Haden-Min/CNN_YOLO_AI_accelerator/legacy/for_conference/dataflow.pptx

## CNN HW Dataflow

2024.07.25 (목)
민한율 한이음 발표자료

## Index

- CONV Layer
- BatchNormalization
- Conv2D
- Input Data
- Data Type
- Quantization
- INT8 Data Flow

## About CONV Layer

Structures of Convolutional Layer

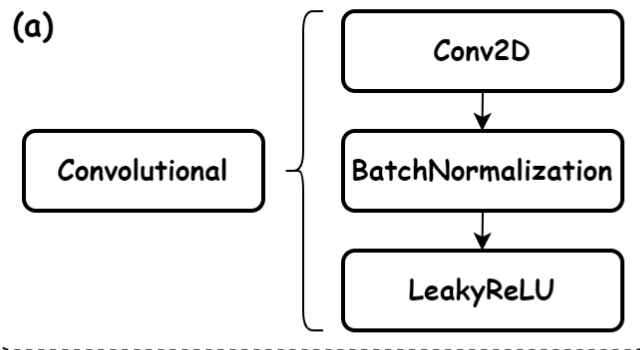
[picture p1: figure]

## (1) About BatchNormalization

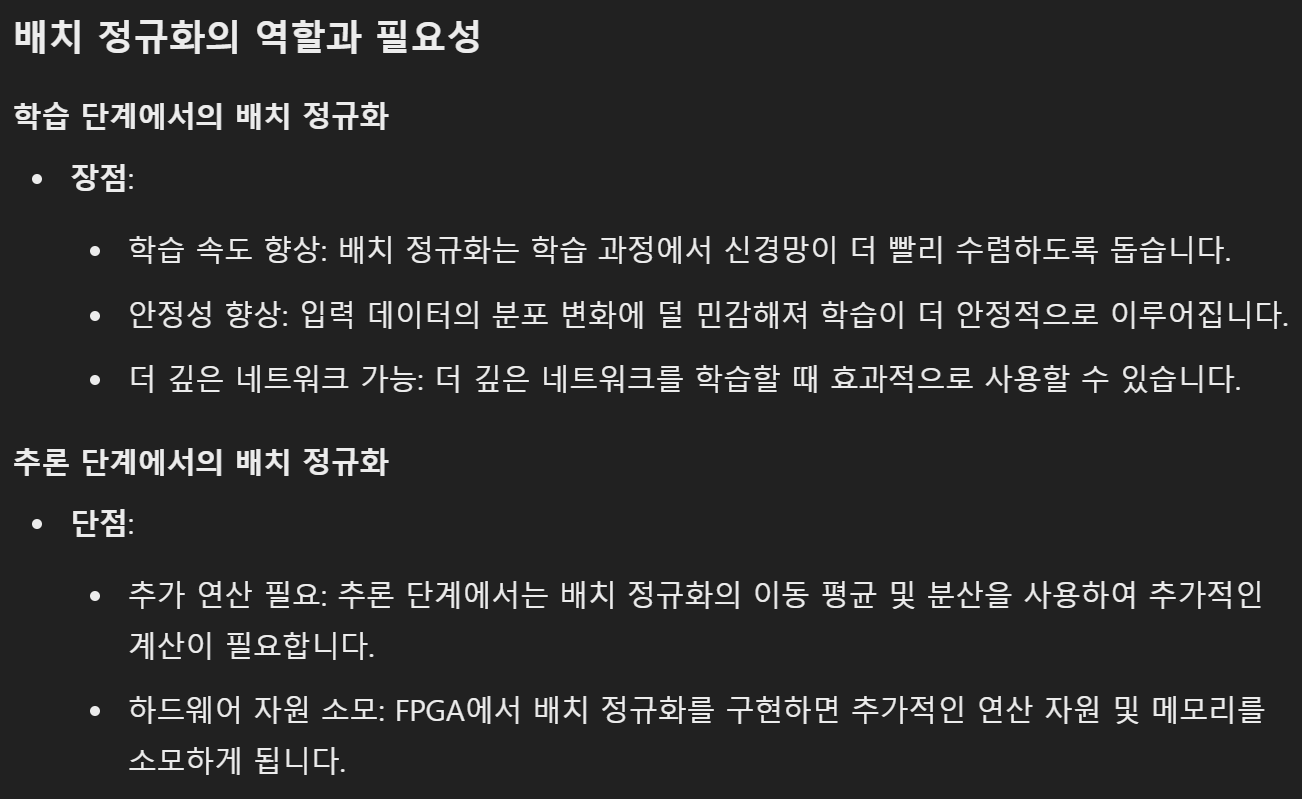
[picture p2: figure]
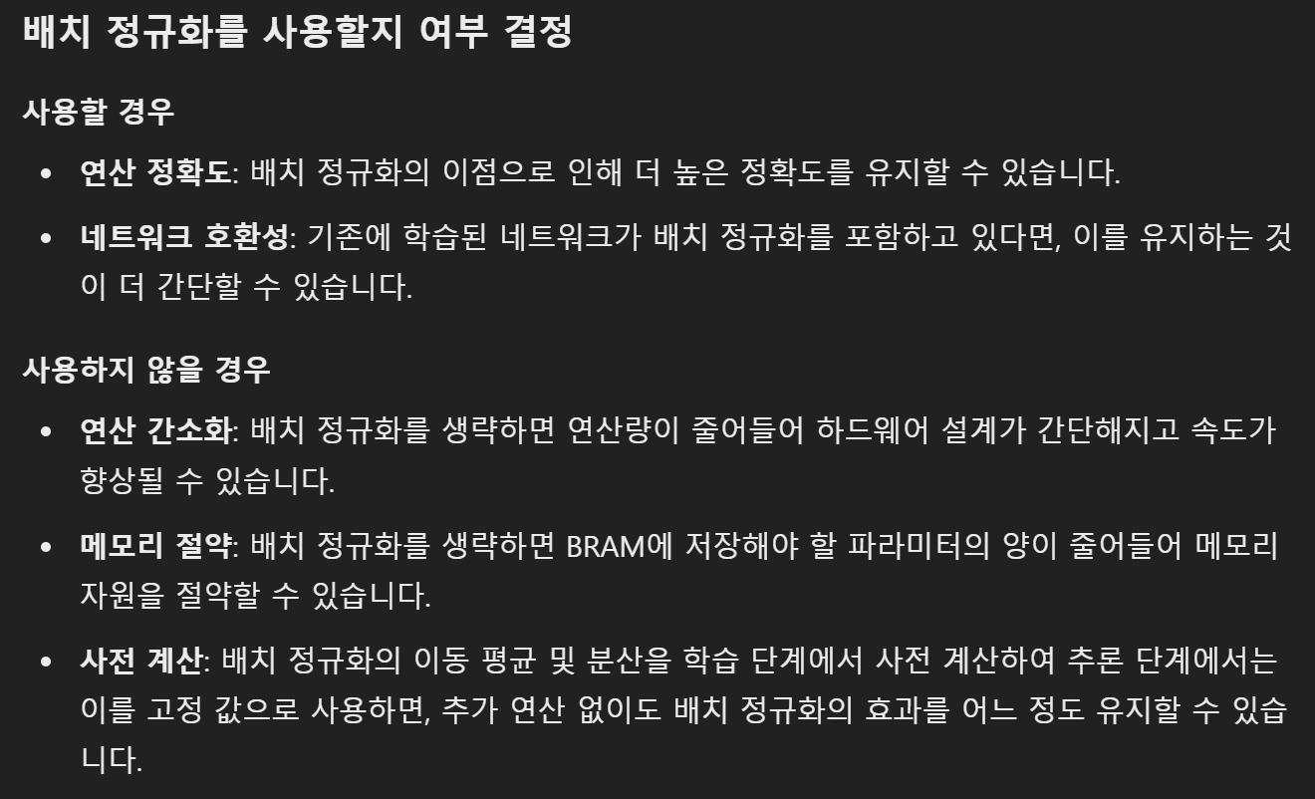
[picture p3: figure]
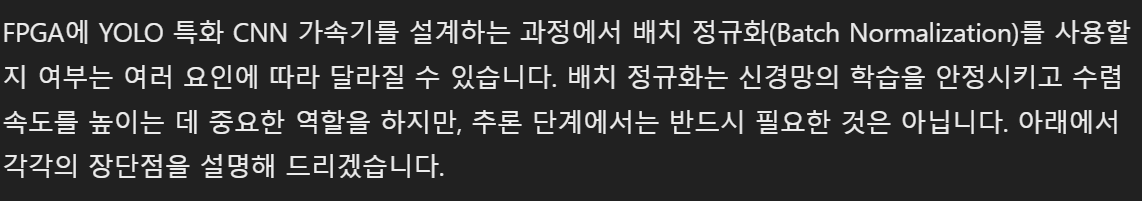
[picture p4: figure]

## (1) About BatchNormalization

Weights_Summary_Corrected.xlsx 추가 자료 참고

빨간 박스가 BatchNorm File

## (2) About Conv2D

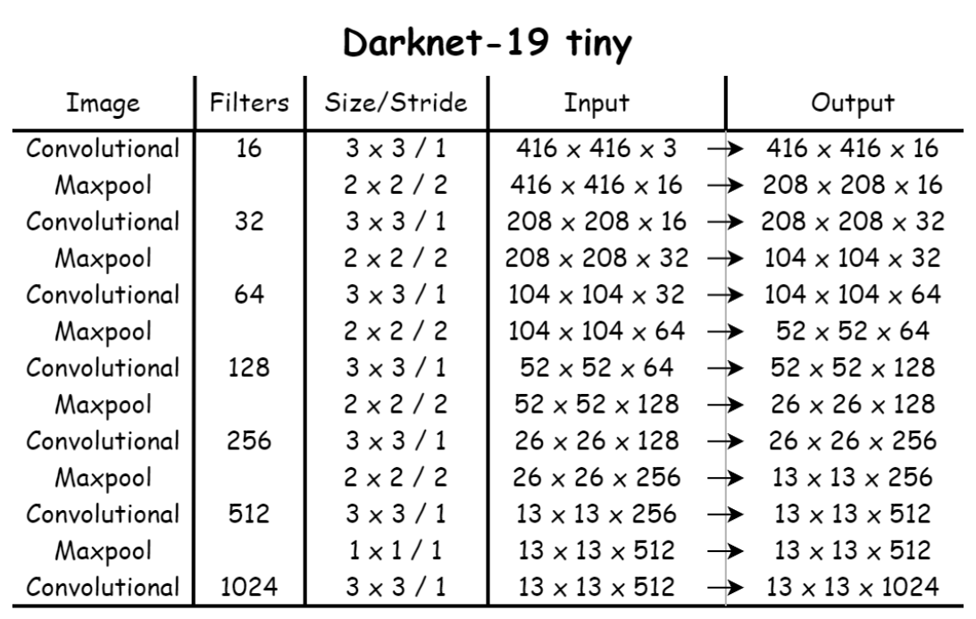
[picture p5: figure]

Example

## (2) About Conv2D

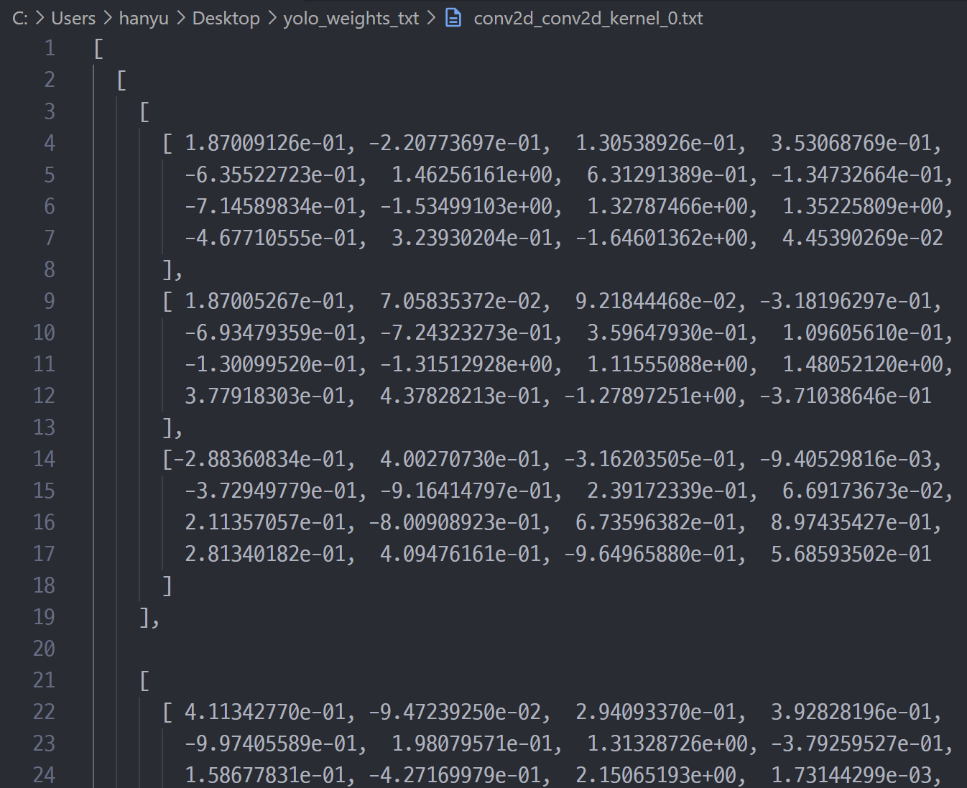
[picture p6: figure]

conv2d weight 중 일부

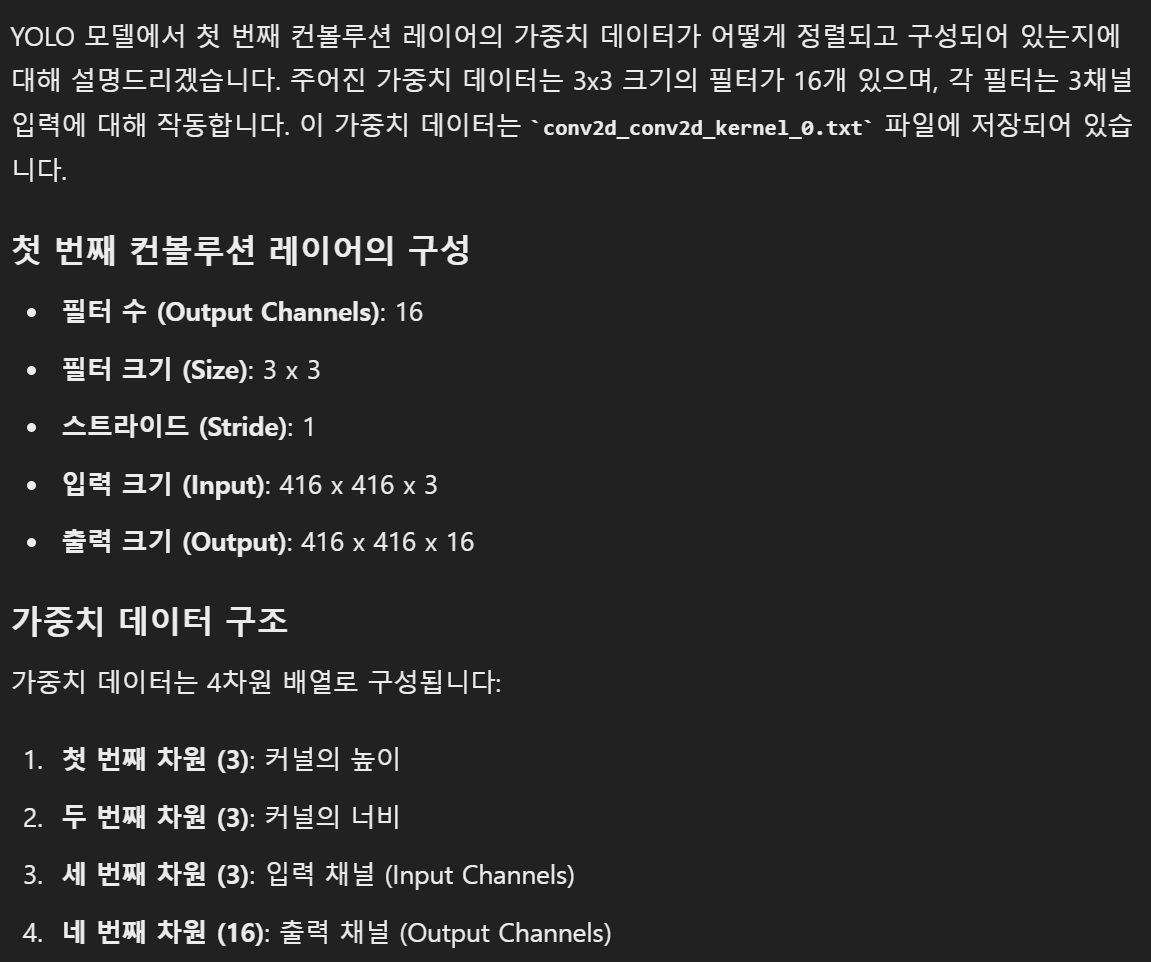
[picture p7: figure]

## (2) About Conv2D

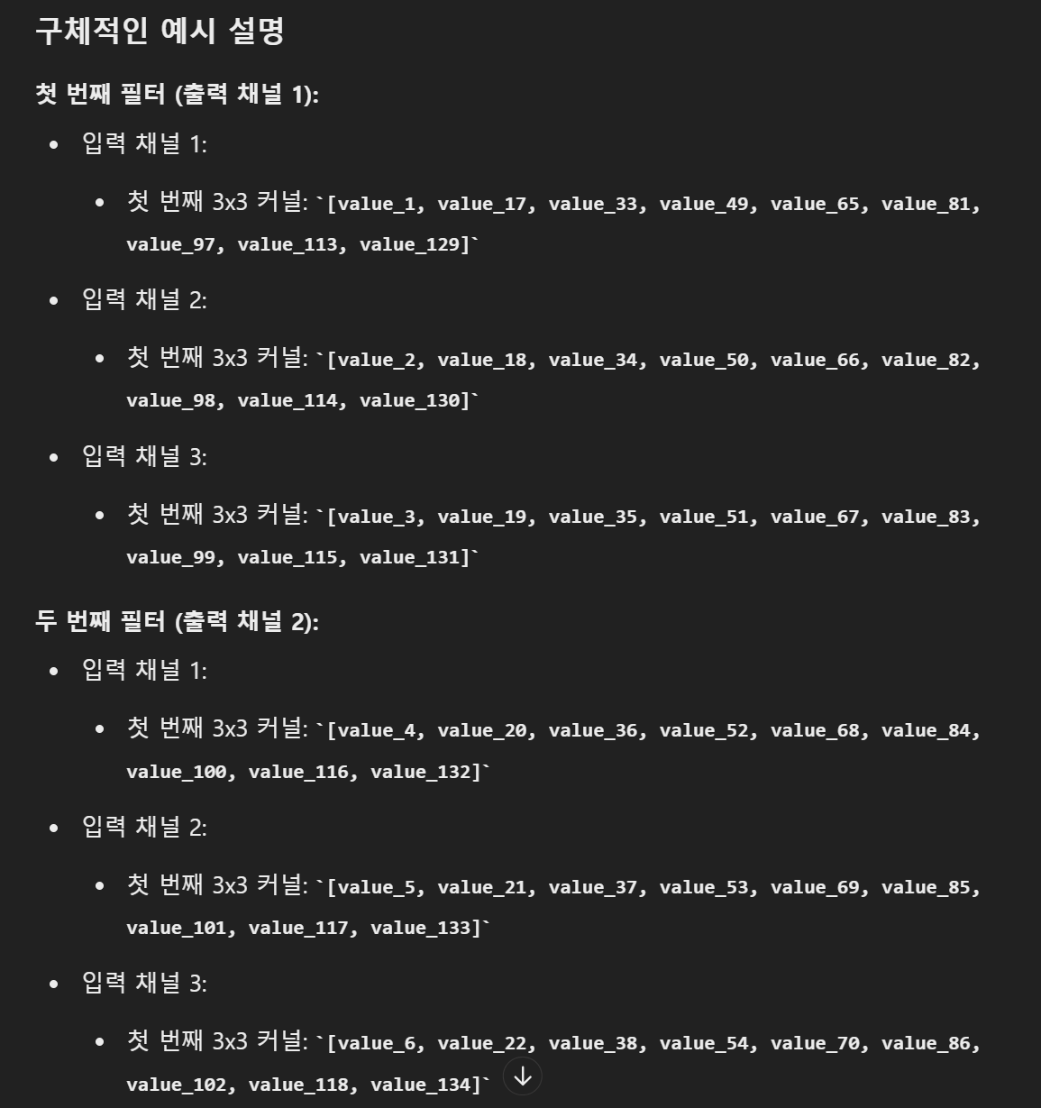
[picture p8: figure]
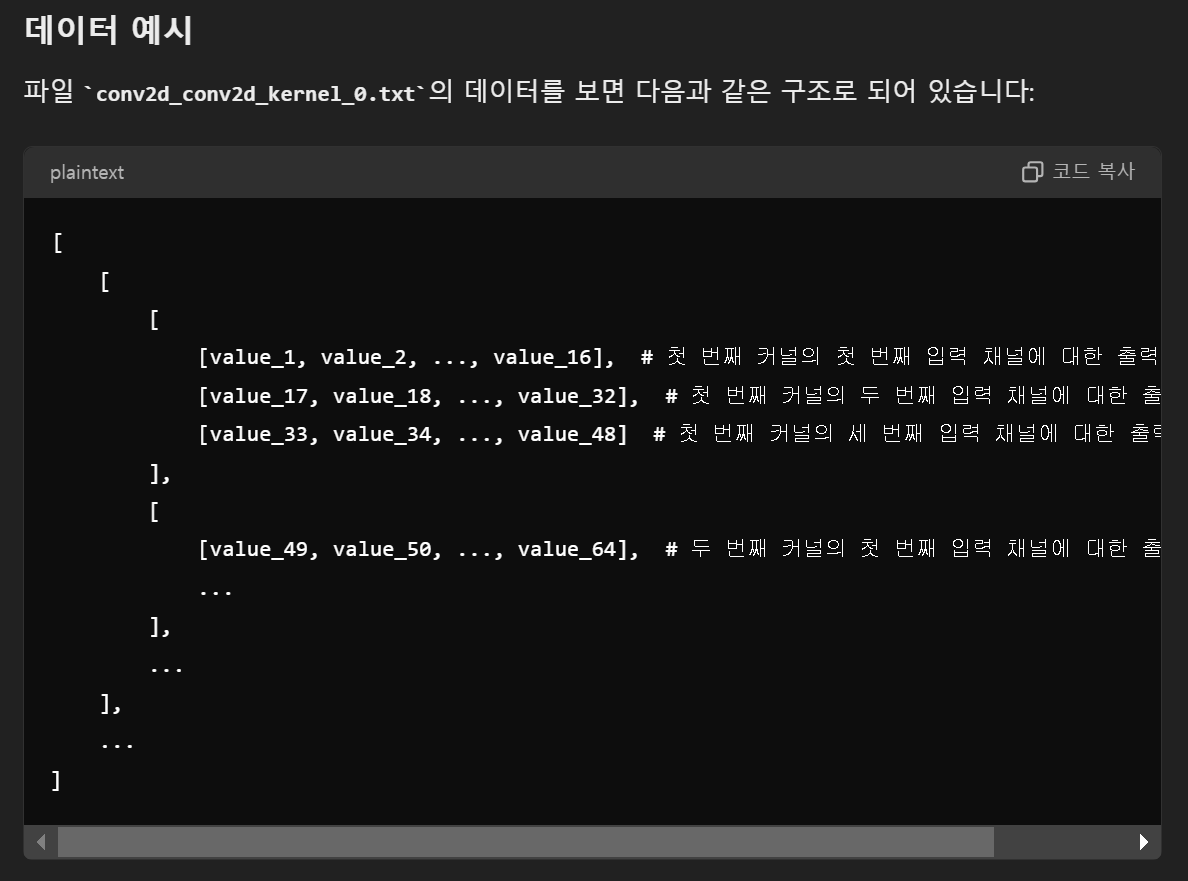
[picture p9: figure]
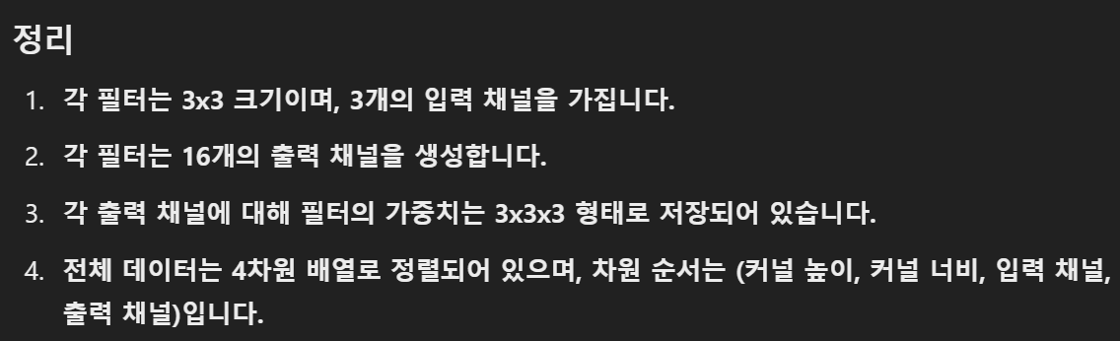
[picture p10: figure]

## (3) About Input Data

DATA

## (3) About Input Data

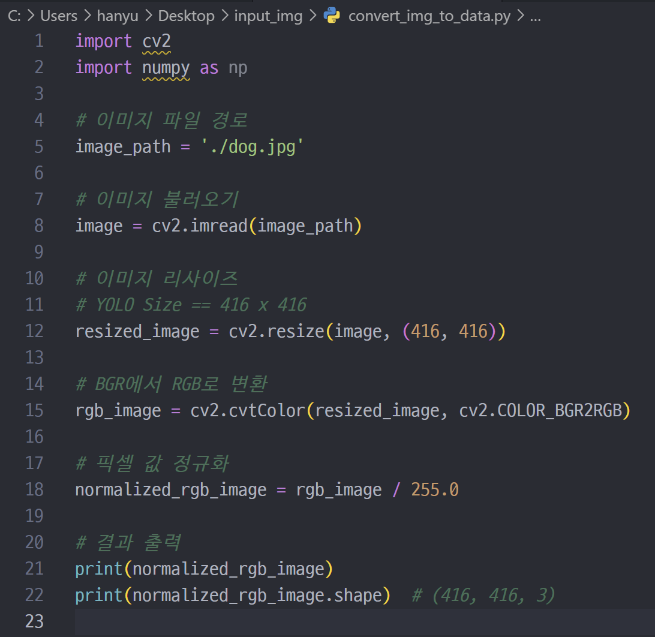
[picture p11: figure]

Reference Code in Python

참고 자료
input_img 폴더 참조

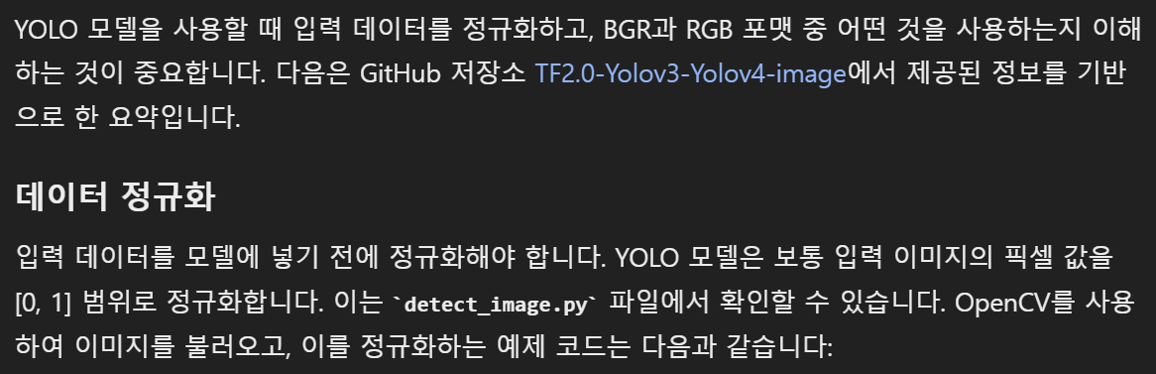
[picture p12: figure]

## (3) About Input Data

- Output

1 pixel [ R, G, B ]

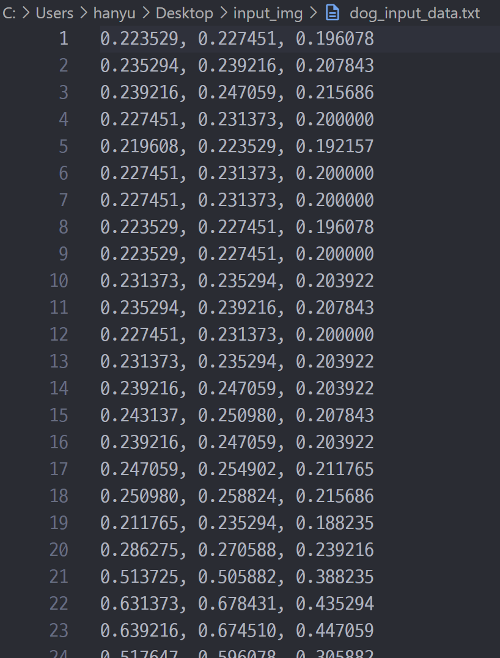
[picture p13: figure]

## (4) About Data Type

Mapping range
INT8: -128 ~ 127
FP32: 아래 사진 참고 (Q16.16 기준)

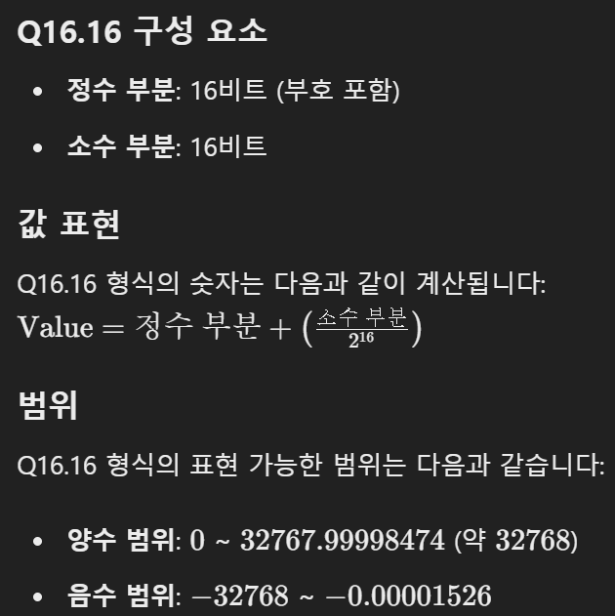
[picture p14: figure]

- INT8
- FP32 (Fixed)
- FP32 (Floating)

## (4) About Data Type

- INT8 vs FP32

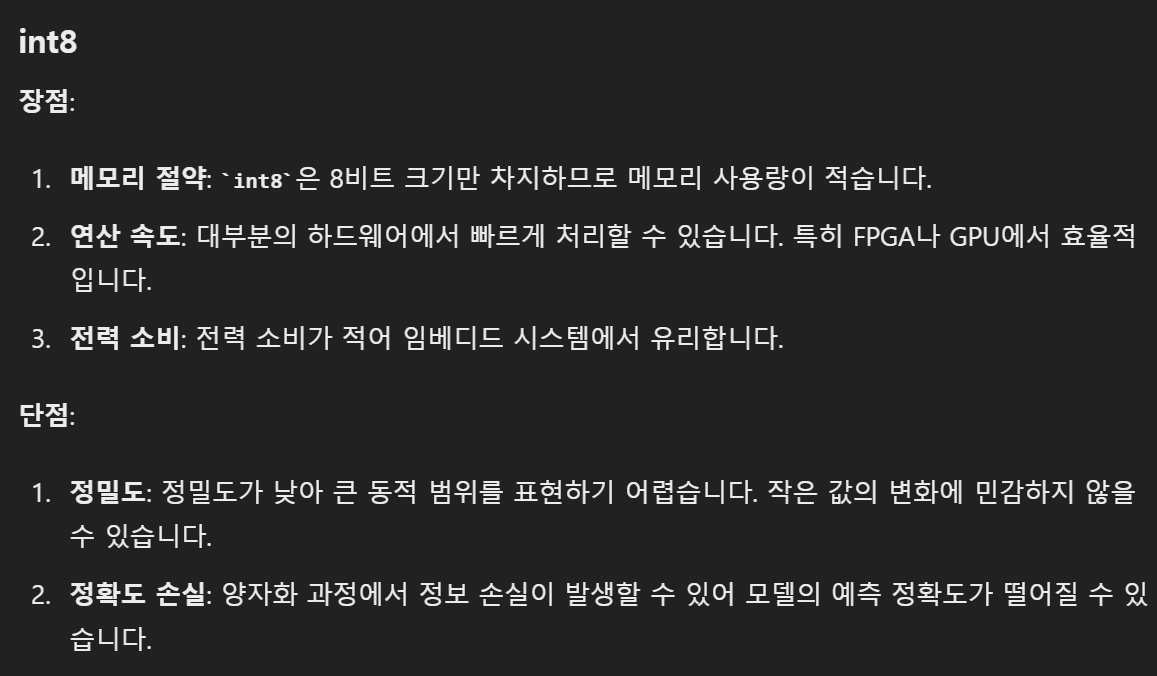
[picture p15: figure]
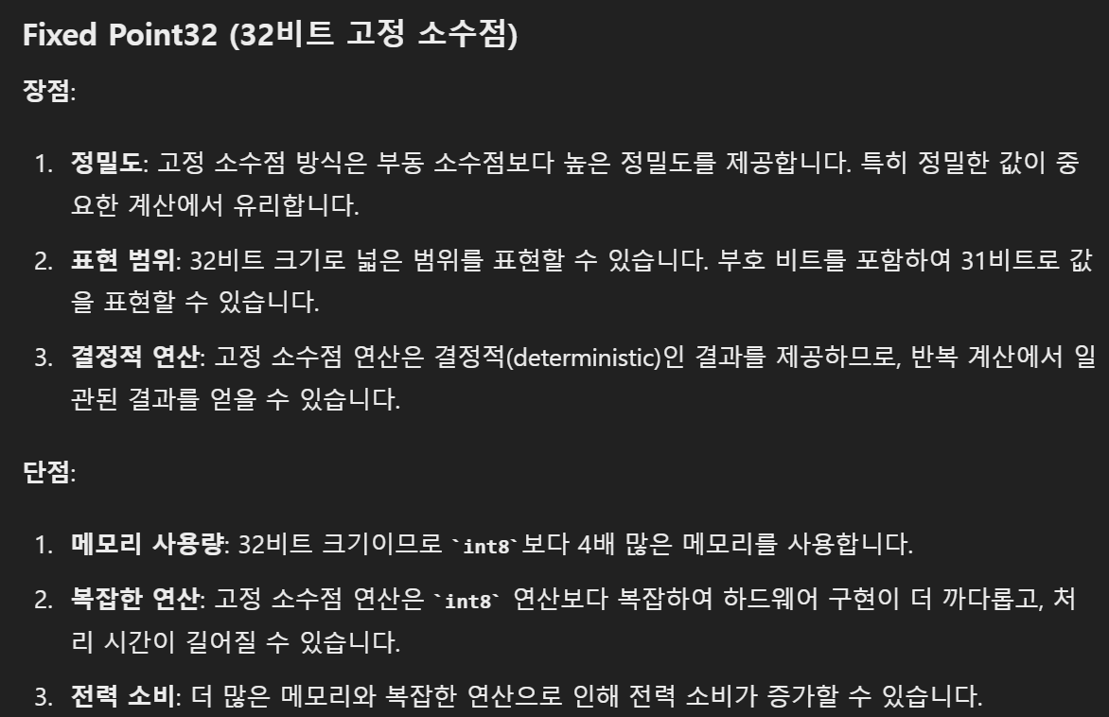
[picture p16: figure]

## (4) About Data Type

- INT8 vs FP32

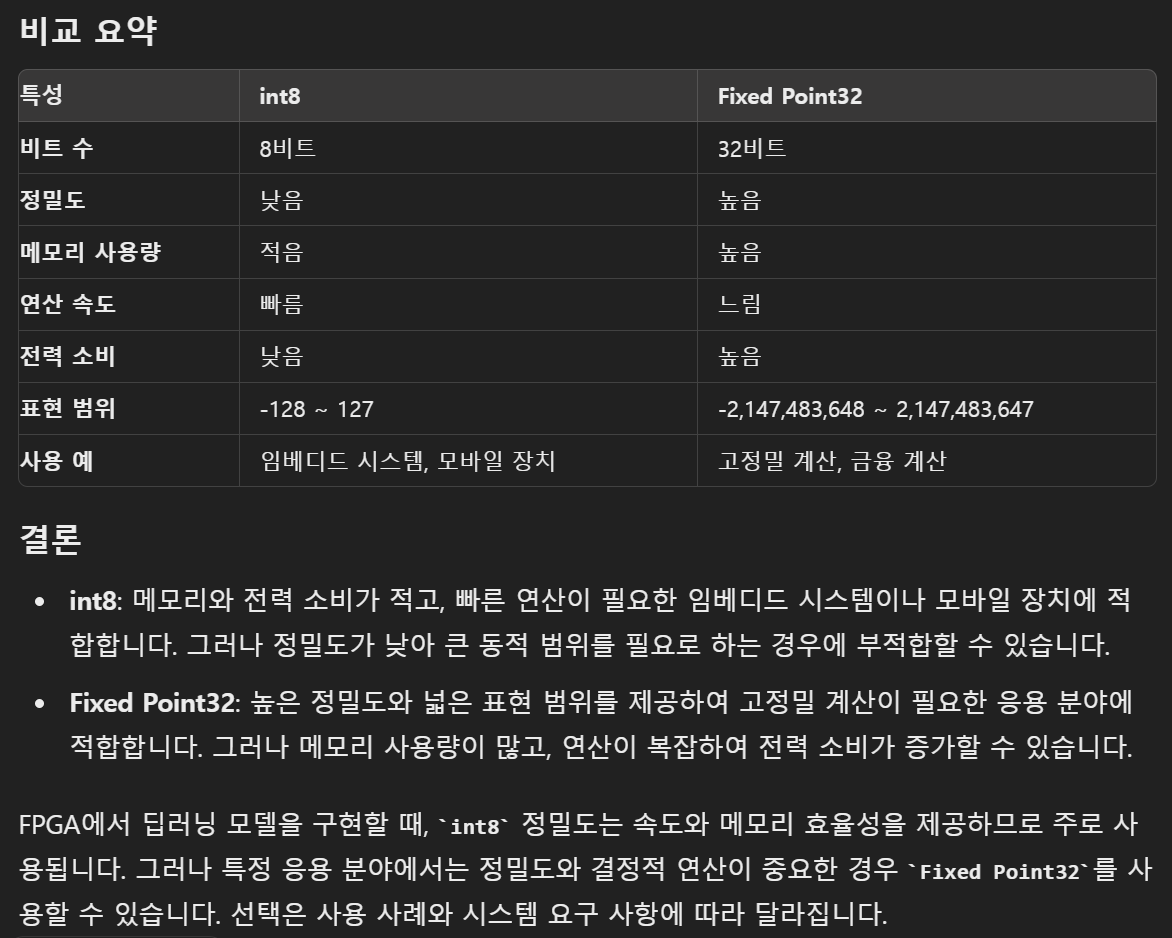
[picture p17: figure]

## (4) About Data Type

- INT8 vs FP32 (Floating Point) 곱셈기 비교

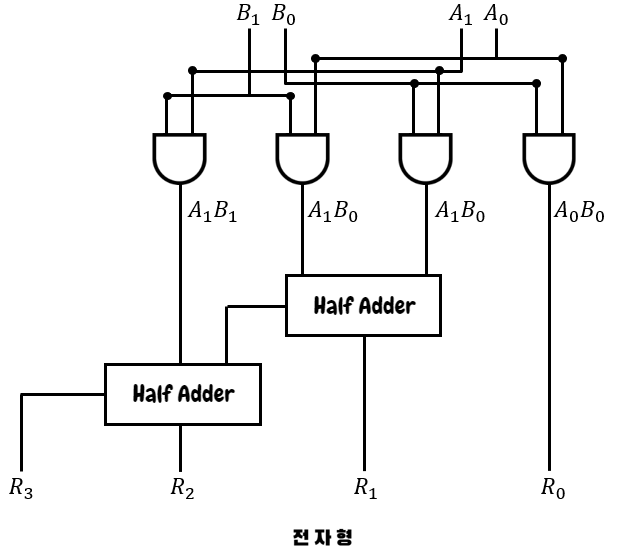
[picture p18: figure]
곱셈기 (Multiplier) - 전자형
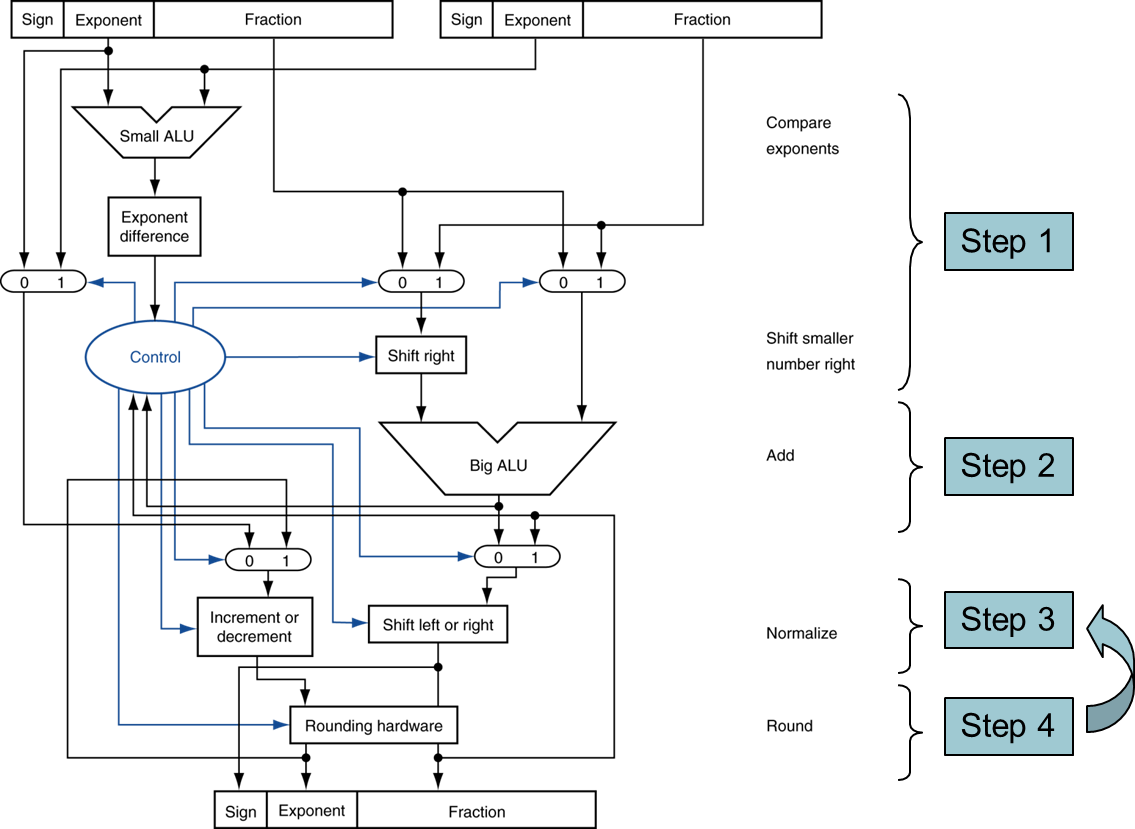
[picture p19: figure]

VS

## (5) About Quantization

- How to convert Data type??
  - “Quantization!!”

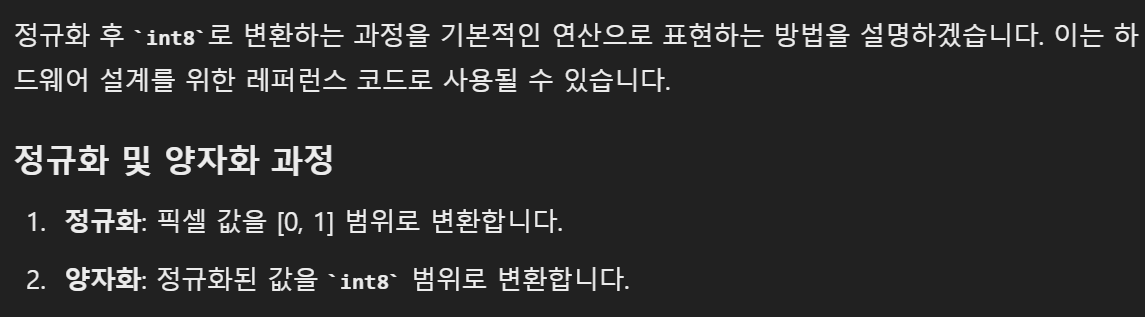
[picture p20: figure]

## (5) About Quantization

- Reference Code (input data)

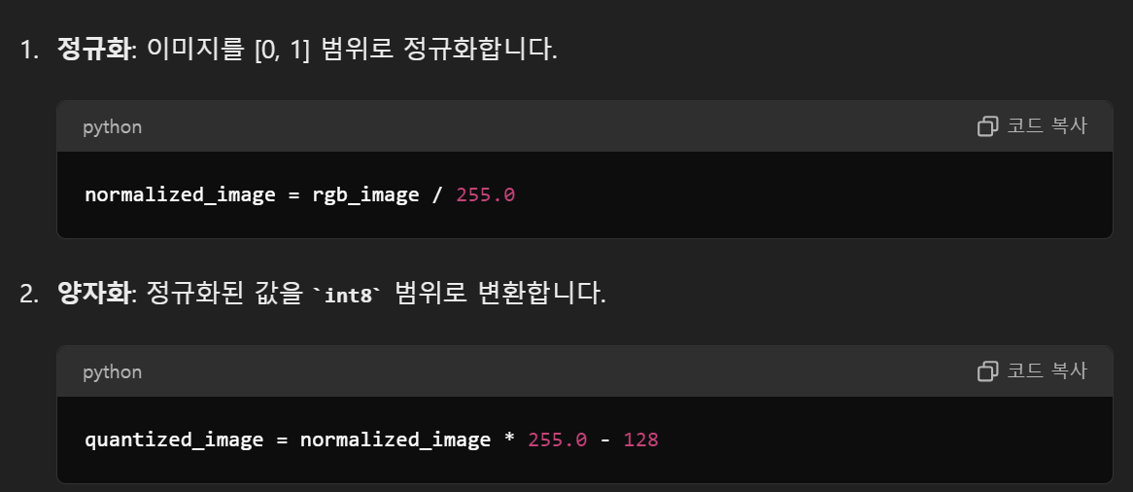
[picture p21: figure]
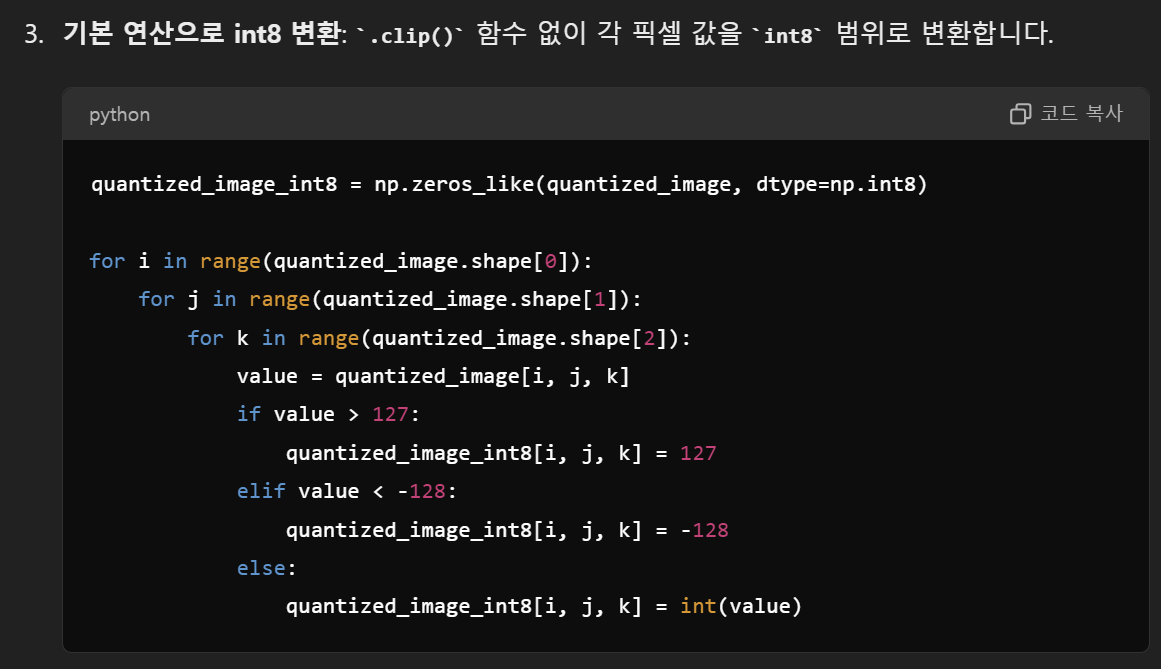
[picture p22: figure]

## (5) About Quantization

- Reference Code without normalization (input data)

## (5) About Quantization

- Why we take normalization?

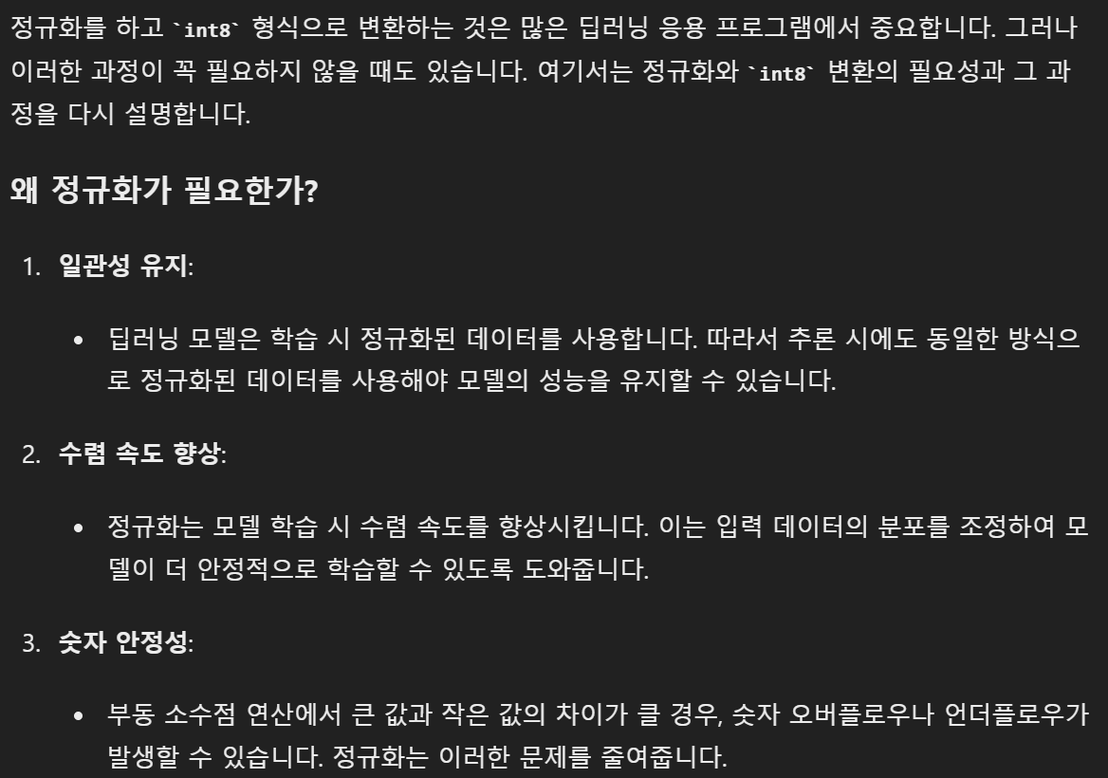
[picture p23: figure]

## (5) About Quantization

- Reference Code (weight)

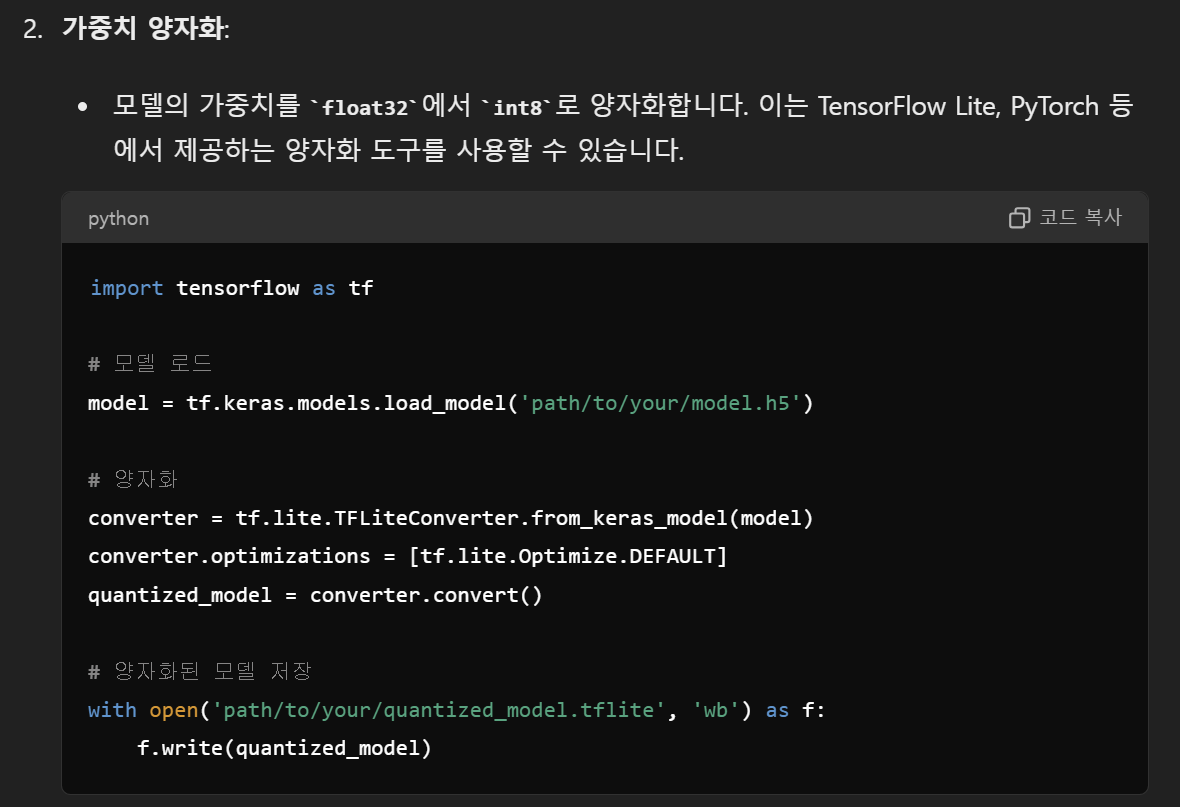
[picture p24: figure]

## (6) About INT8 Dataflow

data visualization

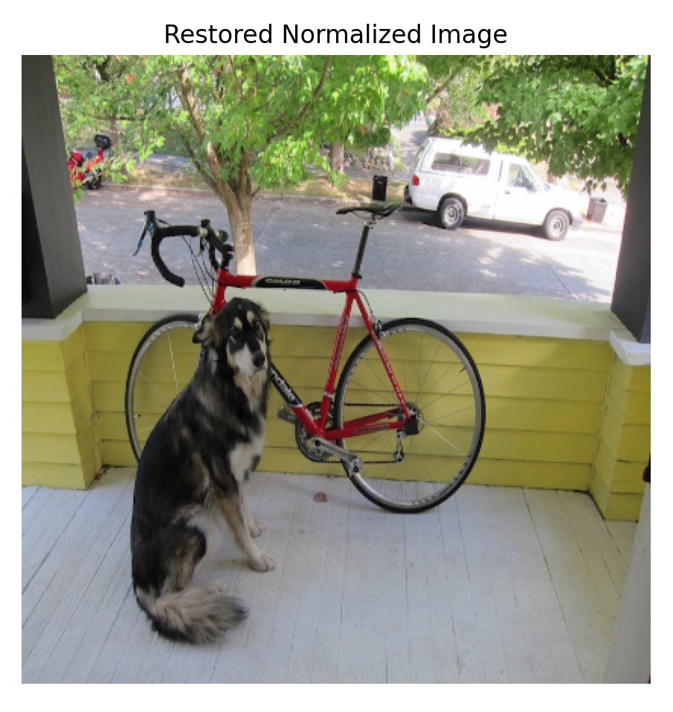
[picture p25: figure]

input image dataflow

normalization

quantization

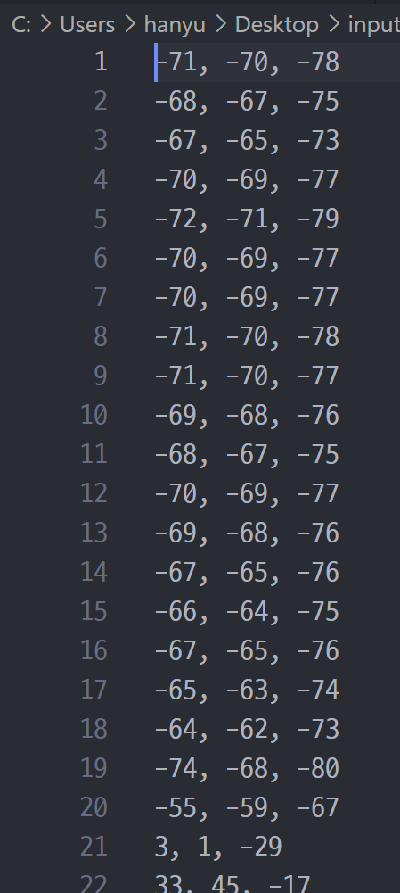
[picture p26: figure]

input img

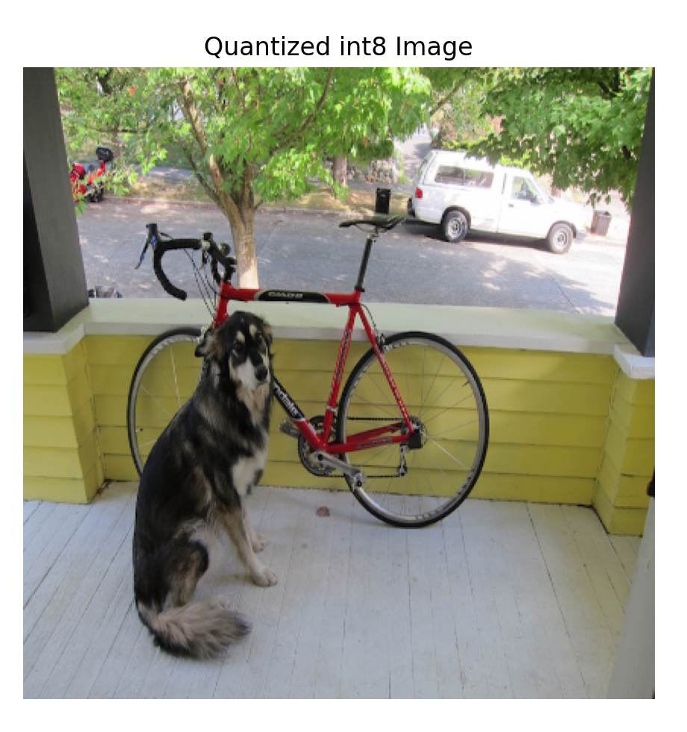
[picture p27: figure]

## (6) About INT8 Dataflow

data visualization

our goal

normalization

quantization

input img

FPGA YOLO Operation

## (6) About INT8 Dataflow

- Weight

구현 실패…
