Haden-Min/CNN_YOLO_AI_accelerator/rtl/tb/tb_single_conv_pipeline.v

`timescale 1ns/1ps

module tb_single_conv_pipeline;
    localparam DATA_WIDTH = 8;
    localparam MUL_WIDTH  = 16;
    localparam ACC_WIDTH  = 32;
    localparam IC = 1;
    localparam OC = 1;
    localparam IN_H = 5;
    localparam IN_W = 5;
    localparam K_H = 3;
    localparam K_W = 3;
    localparam OUT_H = 3;
    localparam OUT_W = 3;
    localparam INPUT_SIZE = IC * IN_H * IN_W;
    localparam WEIGHT_SIZE = OC * IC * K_H * K_W;
    localparam BIAS_SIZE = OC;
    localparam OUTPUT_SIZE = OC * OUT_H * OUT_W;
    localparam INPUT_ADDR_WIDTH = 5;
    localparam WEIGHT_ADDR_WIDTH = 4;
    localparam BIAS_ADDR_WIDTH = 1;
    localparam OUTPUT_ADDR_WIDTH = 4;

    reg clk;
    reg rst_n;
    reg start_i;

    reg input_load_en_i;
    reg [INPUT_ADDR_WIDTH-1:0] input_load_addr_i;
    reg signed [DATA_WIDTH-1:0] input_stream_data_i;

    reg weight_load_en_i;
    reg [WEIGHT_ADDR_WIDTH-1:0] weight_load_addr_i;
    reg signed [DATA_WIDTH-1:0] weight_stream_data_i;

    reg bias_load_en_i;
    reg [BIAS_ADDR_WIDTH-1:0] bias_load_addr_i;
    reg signed [ACC_WIDTH-1:0] bias_load_data_i;

    reg [OUTPUT_ADDR_WIDTH-1:0] output_read_addr_i;

    wire [BIAS_ADDR_WIDTH-1:0] bias_addr_o;
    wire [OUTPUT_ADDR_WIDTH-1:0] output_addr_o;
    wire output_we_o;
    wire busy_o;
    wire done_o;
    wire signed [ACC_WIDTH-1:0] output_data_o;
    wire signed [ACC_WIDTH-1:0] output_read_data_o;

    reg signed [DATA_WIDTH-1:0] input_mem [0:INPUT_SIZE-1];
    reg signed [DATA_WIDTH-1:0] weight_mem [0:WEIGHT_SIZE-1];
    reg signed [ACC_WIDTH-1:0] bias_mem [0:BIAS_SIZE-1];
    reg signed [ACC_WIDTH-1:0] expected_mem [0:OUTPUT_SIZE-1];

    integer fd;
    integer code;
    integer value;
    integer count;
    integer i;
    integer write_count;
    integer mismatch_count;
    integer readback_mismatch_count;
    integer done_seen;
    integer cycles;

    top_single_conv_pipeline #(
        .DATA_WIDTH(DATA_WIDTH),
        .MUL_WIDTH(MUL_WIDTH),
        .ACC_WIDTH(ACC_WIDTH),
        .IC(IC),
        .OC(OC),
        .IN_H(IN_H),
        .IN_W(IN_W),
        .K_H(K_H),
        .K_W(K_W),
        .OUT_H(OUT_H),
        .OUT_W(OUT_W),
        .INPUT_ADDR_WIDTH(INPUT_ADDR_WIDTH),
        .WEIGHT_ADDR_WIDTH(WEIGHT_ADDR_WIDTH),
        .BIAS_ADDR_WIDTH(BIAS_ADDR_WIDTH),
        .OUTPUT_ADDR_WIDTH(OUTPUT_ADDR_WIDTH)
    ) dut (
        .clk(clk),
        .rst_n(rst_n),
        .start_i(start_i),
        .output_ready_i(1'b1),
        .input_load_en_i(input_load_en_i),
        .input_load_addr_i(input_load_addr_i),
        .input_stream_data_i(input_stream_data_i),
        .weight_load_en_i(weight_load_en_i),
        .weight_load_addr_i(weight_load_addr_i),
        .weight_stream_data_i(weight_stream_data_i),
        .bias_load_en_i(bias_load_en_i),
        .bias_load_addr_i(bias_load_addr_i),
        .bias_load_data_i(bias_load_data_i),
        .output_read_addr_i(output_read_addr_i),
        .bias_addr_o(bias_addr_o),
        .output_addr_o(output_addr_o),
        .output_we_o(output_we_o),
        .busy_o(busy_o),
        .done_o(done_o),
        .output_data_o(output_data_o),
        .output_read_data_o(output_read_data_o)
    );

    initial clk = 1'b0;
    always #5 clk = ~clk;

    task open_input_fixture;
        output integer file_desc;
        begin
            file_desc = $fopen("sw/fixture/single_conv_001/input_int8.hex", "r");
            if (file_desc == 0) file_desc = $fopen("../sw/fixture/single_conv_001/input_int8.hex", "r");
            if (file_desc == 0) file_desc = $fopen("../../sw/fixture/single_conv_001/input_int8.hex", "r");
            if (file_desc == 0) file_desc = $fopen("../../../sw/fixture/single_conv_001/input_int8.hex", "r");
            if (file_desc == 0) file_desc = $fopen("../../../../sw/fixture/single_conv_001/input_int8.hex", "r");
            if (file_desc == 0) file_desc = $fopen("../../../../../sw/fixture/single_conv_001/input_int8.hex", "r");
            if (file_desc == 0) file_desc = $fopen("../../../../../CNN_YOLO_AI_accelerator/sw/fixture/single_conv_001/input_int8.hex", "r");
            if (file_desc == 0) file_desc = $fopen("../../../../../../CNN_YOLO_AI_accelerator/sw/fixture/single_conv_001/input_int8.hex", "r");
            if (file_desc == 0) file_desc = $fopen("C:/Users/hanyu/Documents/CNN Accelerator/CNN_YOLO_AI_accelerator/sw/fixture/single_conv_001/input_int8.hex", "r");
        end
    endtask

    task open_weight_fixture;
        output integer file_desc;
        begin
            file_desc = $fopen("sw/fixture/single_conv_001/weight_int8.hex", "r");
            if (file_desc == 0) file_desc = $fopen("../sw/fixture/single_conv_001/weight_int8.hex", "r");
            if (file_desc == 0) file_desc = $fopen("../../sw/fixture/single_conv_001/weight_int8.hex", "r");
            if (file_desc == 0) file_desc = $fopen("../../../sw/fixture/single_conv_001/weight_int8.hex", "r");
            if (file_desc == 0) file_desc = $fopen("../../../../sw/fixture/single_conv_001/weight_int8.hex", "r");
            if (file_desc == 0) file_desc = $fopen("../../../../../sw/fixture/single_conv_001/weight_int8.hex", "r");
            if (file_desc == 0) file_desc = $fopen("../../../../../CNN_YOLO_AI_accelerator/sw/fixture/single_conv_001/weight_int8.hex", "r");
            if (file_desc == 0) file_desc = $fopen("../../../../../../CNN_YOLO_AI_accelerator/sw/fixture/single_conv_001/weight_int8.hex", "r");
            if (file_desc == 0) file_desc = $fopen("C:/Users/hanyu/Documents/CNN Accelerator/CNN_YOLO_AI_accelerator/sw/fixture/single_conv_001/weight_int8.hex", "r");
        end
    endtask

    task open_bias_fixture;
        output integer file_desc;
        begin
            file_desc = $fopen("sw/fixture/single_conv_001/bias_int32.hex", "r");
            if (file_desc == 0) file_desc = $fopen("../sw/fixture/single_conv_001/bias_int32.hex", "r");
            if (file_desc == 0) file_desc = $fopen("../../sw/fixture/single_conv_001/bias_int32.hex", "r");
            if (file_desc == 0) file_desc = $fopen("../../../sw/fixture/single_conv_001/bias_int32.hex", "r");
            if (file_desc == 0) file_desc = $fopen("../../../../sw/fixture/single_conv_001/bias_int32.hex", "r");
            if (file_desc == 0) file_desc = $fopen("../../../../../sw/fixture/single_conv_001/bias_int32.hex", "r");
            if (file_desc == 0) file_desc = $fopen("../../../../../CNN_YOLO_AI_accelerator/sw/fixture/single_conv_001/bias_int32.hex", "r");
            if (file_desc == 0) file_desc = $fopen("../../../../../../CNN_YOLO_AI_accelerator/sw/fixture/single_conv_001/bias_int32.hex", "r");
            if (file_desc == 0) file_desc = $fopen("C:/Users/hanyu/Documents/CNN Accelerator/CNN_YOLO_AI_accelerator/sw/fixture/single_conv_001/bias_int32.hex", "r");
        end
    endtask

    task open_expected_fixture;
        output integer file_desc;
        begin
            file_desc = $fopen("sw/fixture/single_conv_001/expected_acc_int32.hex", "r");
            if (file_desc == 0) file_desc = $fopen("../sw/fixture/single_conv_001/expected_acc_int32.hex", "r");
            if (file_desc == 0) file_desc = $fopen("../../sw/fixture/single_conv_001/expected_acc_int32.hex", "r");
            if (file_desc == 0) file_desc = $fopen("../../../sw/fixture/single_conv_001/expected_acc_int32.hex", "r");
            if (file_desc == 0) file_desc = $fopen("../../../../sw/fixture/single_conv_001/expected_acc_int32.hex", "r");
            if (file_desc == 0) file_desc = $fopen("../../../../../sw/fixture/single_conv_001/expected_acc_int32.hex", "r");
            if (file_desc == 0) file_desc = $fopen("../../../../../CNN_YOLO_AI_accelerator/sw/fixture/single_conv_001/expected_acc_int32.hex", "r");
            if (file_desc == 0) file_desc = $fopen("../../../../../../CNN_YOLO_AI_accelerator/sw/fixture/single_conv_001/expected_acc_int32.hex", "r");
            if (file_desc == 0) file_desc = $fopen("C:/Users/hanyu/Documents/CNN Accelerator/CNN_YOLO_AI_accelerator/sw/fixture/single_conv_001/expected_acc_int32.hex", "r");
        end
    endtask

    task load_input_file;
        begin
            count = 0;
            open_input_fixture(fd);
            if (fd == 0) begin
                $display("FAIL: cannot open input fixture input_int8.hex");
                $display("Hint: run simulation from the repository root or keep the repo at C:/Users/hanyu/Documents/CNN Accelerator/CNN_YOLO_AI_accelerator");
                $finish;
            end
            while (!$feof(fd)) begin
                code = $fscanf(fd, "%d\n", value);
                if (code == 1) begin input_mem[count] = value; count = count + 1; end
            end
            $fclose(fd);
        end
    endtask

    task load_weight_file;
        begin
            count = 0;
            open_weight_fixture(fd);
            if (fd == 0) begin
                $display("FAIL: cannot open weight fixture weight_int8.hex");
                $display("Hint: run simulation from the repository root or keep the repo at C:/Users/hanyu/Documents/CNN Accelerator/CNN_YOLO_AI_accelerator");
                $finish;
            end
            while (!$feof(fd)) begin
                code = $fscanf(fd, "%d\n", value);
                if (code == 1) begin weight_mem[count] = value; count = count + 1; end
            end
            $fclose(fd);
        end
    endtask

    task load_bias_file;
        begin
            count = 0;
            open_bias_fixture(fd);
            if (fd == 0) begin
                $display("FAIL: cannot open bias fixture bias_int32.hex");
                $display("Hint: run simulation from the repository root or keep the repo at C:/Users/hanyu/Documents/CNN Accelerator/CNN_YOLO_AI_accelerator");
                $finish;
            end
            while (!$feof(fd)) begin
                code = $fscanf(fd, "%d\n", value);
                if (code == 1) begin bias_mem[count] = value; count = count + 1; end
            end
            $fclose(fd);
        end
    endtask

    task load_expected_file;
        begin
            count = 0;
            open_expected_fixture(fd);
            if (fd == 0) begin
                $display("FAIL: cannot open expected fixture expected_acc_int32.hex");
                $display("Hint: run simulation from the repository root or keep the repo at C:/Users/hanyu/Documents/CNN Accelerator/CNN_YOLO_AI_accelerator");
                $finish;
            end
            while (!$feof(fd)) begin
                code = $fscanf(fd, "%d\n", value);
                if (code == 1) begin expected_mem[count] = value; count = count + 1; end
            end
            $fclose(fd);
        end
    endtask

    task ps_write_input_row;
        input integer row_idx;
        integer ch_idx;
        integer col_idx;
        integer flat_idx;
        begin
            $display("[PS] stream input row=%0d into line buffer", row_idx);
            input_load_en_i = 1'b1;
            for (ch_idx = 0; ch_idx < IC; ch_idx = ch_idx + 1) begin
                for (col_idx = 0; col_idx < IN_W; col_idx = col_idx + 1) begin
                    flat_idx = ch_idx * IN_H * IN_W + row_idx * IN_W + col_idx;
                    input_load_addr_i = flat_idx[INPUT_ADDR_WIDTH-1:0];
                    input_stream_data_i = input_mem[flat_idx];
                    @(posedge clk);
                    @(negedge clk);
                end
            end
            input_load_en_i = 1'b0;
            input_load_addr_i = {INPUT_ADDR_WIDTH{1'b0}};
            input_stream_data_i = {DATA_WIDTH{1'b0}};
        end
    endtask

    task ps_write_initial_input_lines;
        integer row_idx;
        begin
            $display("[PS] preload first %0d input rows into line buffer", K_H);
            for (row_idx = 0; row_idx < K_H; row_idx = row_idx + 1) begin
                ps_write_input_row(row_idx);
            end
        end
    endtask

    task ps_stream_remaining_input_lines;
        integer next_row_idx;
        integer output_row_done_addr;
        begin
            next_row_idx = K_H;
            while (next_row_idx < IN_H) begin
                output_row_done_addr = (next_row_idx - K_H) * OUT_W + (OUT_W - 1);

                while (!(output_we_o && output_addr_o == output_row_done_addr[OUTPUT_ADDR_WIDTH-1:0])) begin
                    @(posedge clk);
                    #1;
                end

                ps_write_input_row(next_row_idx);
                next_row_idx = next_row_idx + 1;
            end
        end
    endtask

    task ps_write_weight_memory;
        begin
            $display("[PS] write weight memory");
            weight_load_en_i = 1'b1;
            for (i = 0; i < WEIGHT_SIZE; i = i + 1) begin
                weight_load_addr_i = i[WEIGHT_ADDR_WIDTH-1:0];
                weight_stream_data_i = weight_mem[i];
                @(posedge clk);
                @(negedge clk);
            end
            weight_load_en_i = 1'b0;
            weight_load_addr_i = {WEIGHT_ADDR_WIDTH{1'b0}};
            weight_stream_data_i = {DATA_WIDTH{1'b0}};
        end
    endtask

    task ps_write_bias_memory;
        begin
            $display("[PS] write bias memory");
            bias_load_en_i = 1'b1;
            for (i = 0; i < BIAS_SIZE; i = i + 1) begin
                bias_load_addr_i = i[BIAS_ADDR_WIDTH-1:0];
                bias_load_data_i = bias_mem[i];
                @(posedge clk);
                @(negedge clk);
            end
            bias_load_en_i = 1'b0;
            bias_load_addr_i = {BIAS_ADDR_WIDTH{1'b0}};
            bias_load_data_i = {ACC_WIDTH{1'b0}};
        end
    endtask

    task ps_load_operands;
        begin
            ps_write_initial_input_lines();
            ps_write_weight_memory();
            ps_write_bias_memory();
        end
    endtask

    task ps_start_accelerator;
        begin
            $display("[PS] start accelerator");
            start_i = 1'b1;
            @(posedge clk);
            start_i = 1'b0;
        end
    endtask

    task ps_wait_done_and_check_live_writes;
        begin
            $display("[PS] wait done and watch PL output writes");
            done_seen = 0;
            cycles = 0;

            while (done_seen == 0 && cycles < 200) begin
                @(posedge clk);
                #1;
                cycles = cycles + 1;

                if (output_we_o) begin
                    $display("[PL->MEM] output_we addr=%0d data=%0d expected=%0d",
                             output_addr_o, output_data_o, expected_mem[output_addr_o]);

                    if (output_data_o !== expected_mem[output_addr_o]) begin
                        $display("[FAIL] live output mismatch addr=%0d got=%0d expected=%0d",
                                 output_addr_o, output_data_o, expected_mem[output_addr_o]);
                        mismatch_count = mismatch_count + 1;
                    end
                    write_count = write_count + 1;
                end

                if (done_o) begin
                    done_seen = 1;
                    $display("[PL] done asserted after %0d cycles", cycles);
                end
            end
        end
    endtask

    task ps_readback_output_memory;
        begin
            $display("[PS] read back output memory");
            for (i = 0; i < OUTPUT_SIZE; i = i + 1) begin
                output_read_addr_i = i[OUTPUT_ADDR_WIDTH-1:0];
                @(posedge clk);
                #1;

                $display("[PS<-MEM] output_addr=%0d got=%0d expected=%0d",
                         i, output_read_data_o, expected_mem[i]);

                if (output_read_data_o !== expected_mem[i]) begin
                    $display("[FAIL] readback mismatch addr=%0d got=%0d expected=%0d",
                             i, output_read_data_o, expected_mem[i]);
                    readback_mismatch_count = readback_mismatch_count + 1;
                end

            end
        end
    endtask

    initial begin
        load_input_file();
        load_weight_file();
        load_bias_file();
        load_expected_file();

        start_i = 1'b0;
        input_load_en_i = 1'b0;
        input_load_addr_i = {INPUT_ADDR_WIDTH{1'b0}};
        input_stream_data_i = {DATA_WIDTH{1'b0}};
        weight_load_en_i = 1'b0;
        weight_load_addr_i = {WEIGHT_ADDR_WIDTH{1'b0}};
        weight_stream_data_i = {DATA_WIDTH{1'b0}};
        bias_load_en_i = 1'b0;
        bias_load_addr_i = {BIAS_ADDR_WIDTH{1'b0}};
        bias_load_data_i = {ACC_WIDTH{1'b0}};
        output_read_addr_i = {OUTPUT_ADDR_WIDTH{1'b0}};
        write_count = 0;
        mismatch_count = 0;
        readback_mismatch_count = 0;
        done_seen = 0;
        cycles = 0;

        rst_n = 1'b0;
        repeat (2) @(posedge clk);
        rst_n = 1'b1;
        @(posedge clk);

        ps_load_operands();
        ps_start_accelerator();

        fork
            ps_stream_remaining_input_lines();
            ps_wait_done_and_check_live_writes();
        join

        if (cycles >= 200) begin
            $display("FAIL: timeout waiting for done_o");
            $finish;
        end
        if (write_count != OUTPUT_SIZE) begin
            $display("FAIL: write_count=%0d expected=%0d", write_count, OUTPUT_SIZE);
            $finish;
        end

        ps_readback_output_memory();

        if (mismatch_count != 0 || readback_mismatch_count != 0) begin
            $display("FAIL: live_mismatch=%0d readback_mismatch=%0d writes=%0d cycles=%0d",
                     mismatch_count, readback_mismatch_count, write_count, cycles);
        end
        else begin
            $display("PASS: tb_single_conv_pipeline writes=%0d cycles=%0d",
                     write_count, cycles);
        end

        $finish;
    end
endmodule
