Haden-Min/CNN_YOLO_AI_accelerator/(commit log)

2026-07-01 Add pipeline convolution testbench and 416x416 fixtures
    [tb_single_conv_pipeline_v2_416.v]
2026-08-20 Add PYNQ-Z2 bring-up flow and organize RTL
2026-09-02 Add fused activation and INT8 requantization pipeline
    [yolov3_tiny_requant_params.csv]
